Elecrow-RD/Elecrow-nRFLR1121-Wireless-Transceiver-Module/lora_development_board/readme.md

### Corresponding modules use corresponding development boards: 

##### nRFLRxxxx: the corresponding development board is Transceiver Module Dev Board (with Transceiver Module Dev Board (with MCU)_V0.1.
