Elecrow-RD/Elecrow-nRFLR1121-Wireless-Transceiver-Module/Dimension_figure/nRFLR1121-Pin_Definition4.jpg

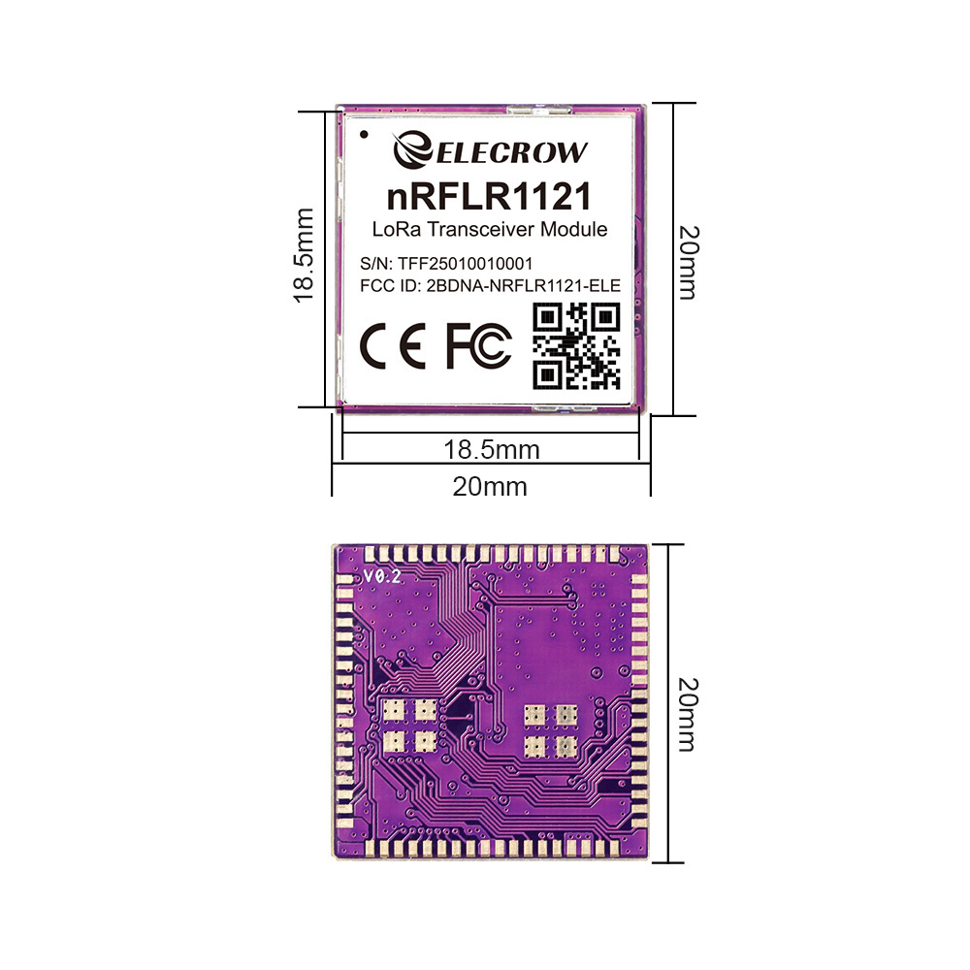
Dimension_figure/nRFLR1121-Pin_Definition4.jpg
